Italkebby/Mazda-3-tape-md-aux/btmodule.jpg

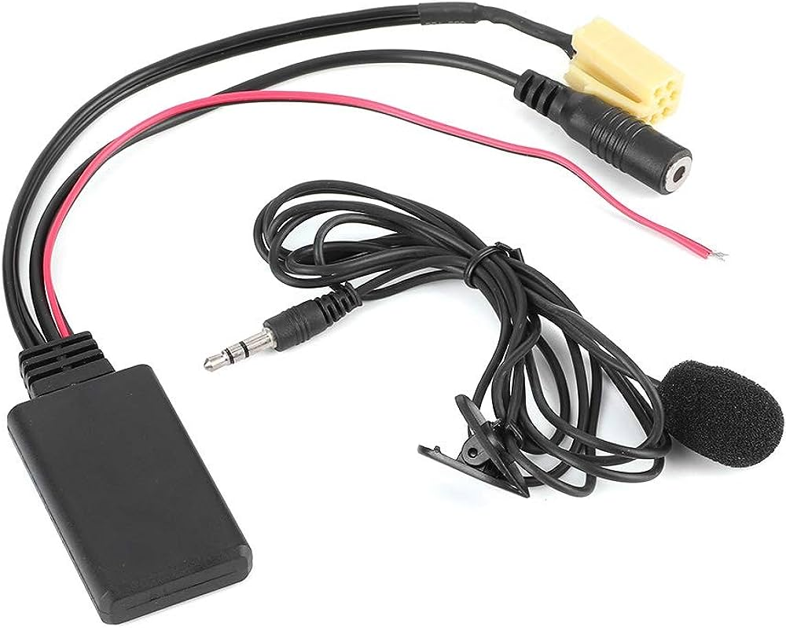
btmodule.jpg
