Italkebby/Mazda-3-tape-md-aux/groundloopinsulator.jpg

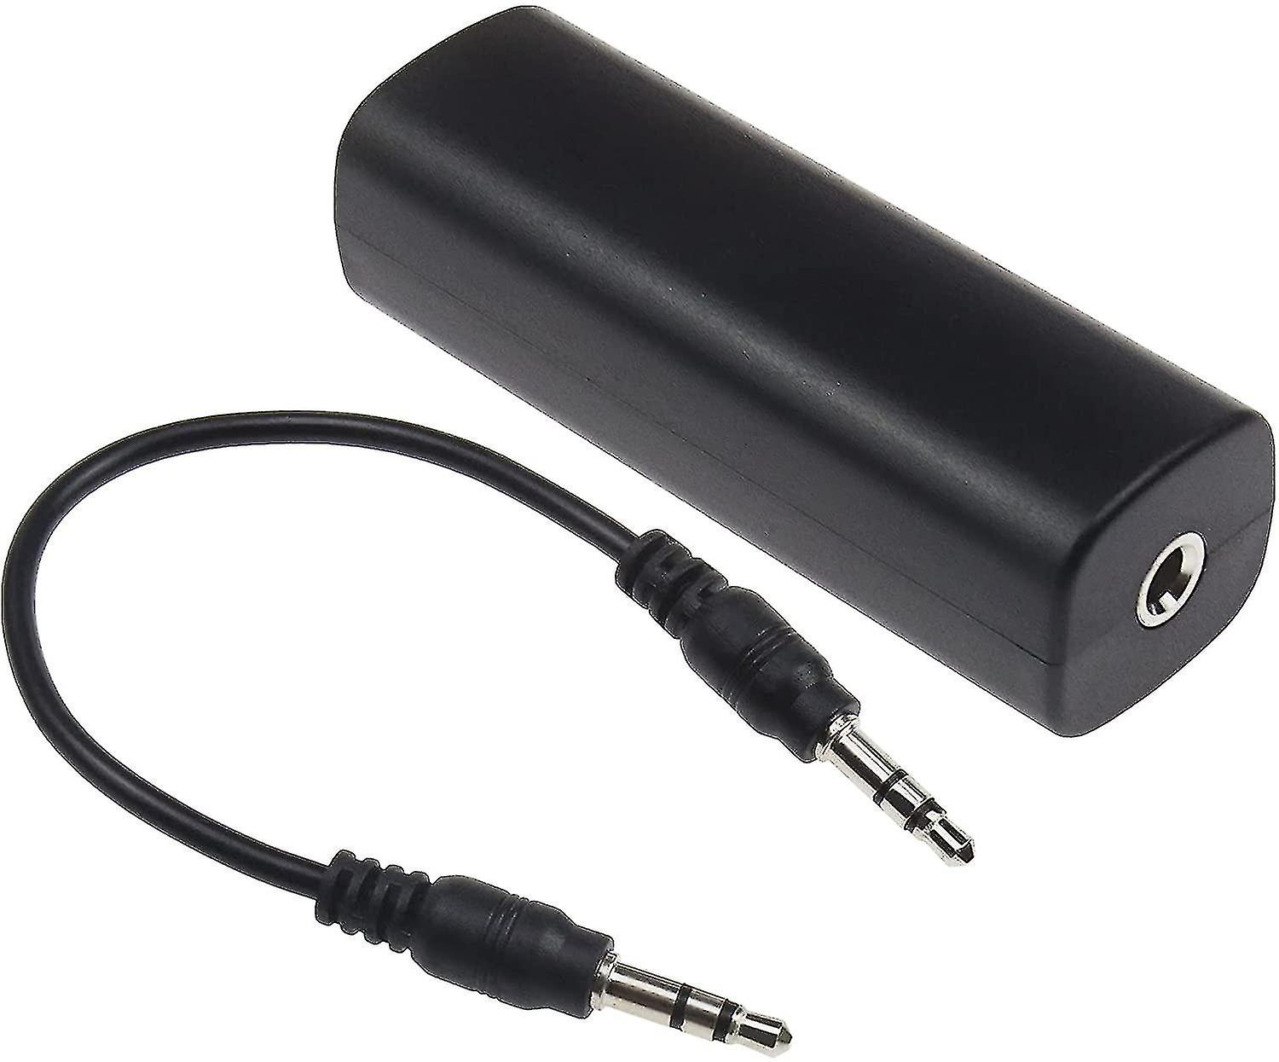
groundloopinsulator.jpg
