Italkebby/Mazda-3-tape-md-aux/mazda_3_int_large.jpg

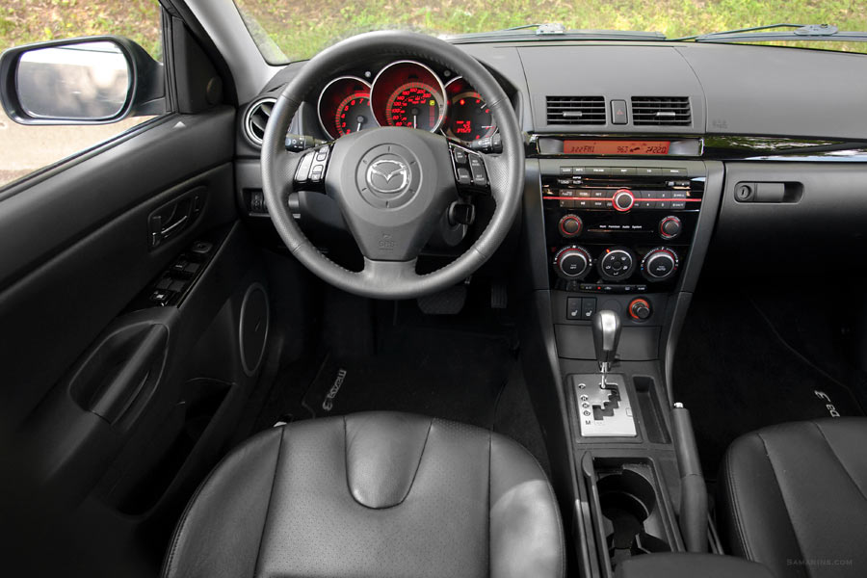
mazda_3_int_large.jpg
