Italkebby/Mazda-3-tape-md-aux/Photos/All in the free space (2).jpg

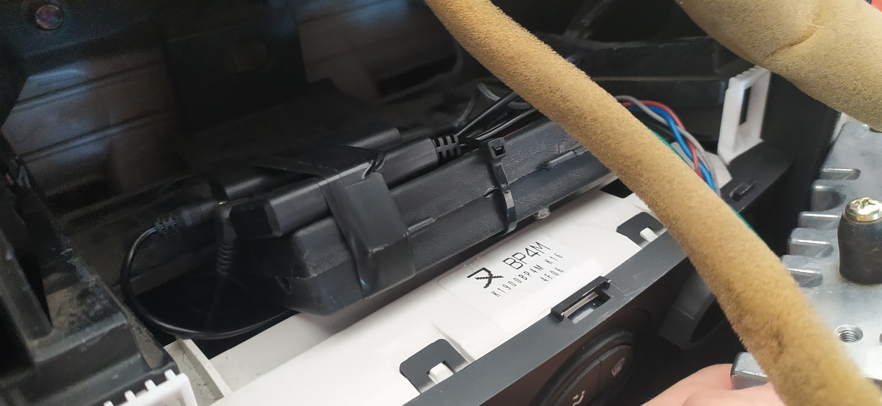
Photos/All in the free space (2).jpg
