Italkebby/Mazda-3-tape-md-aux/Photos/all the system.jpg

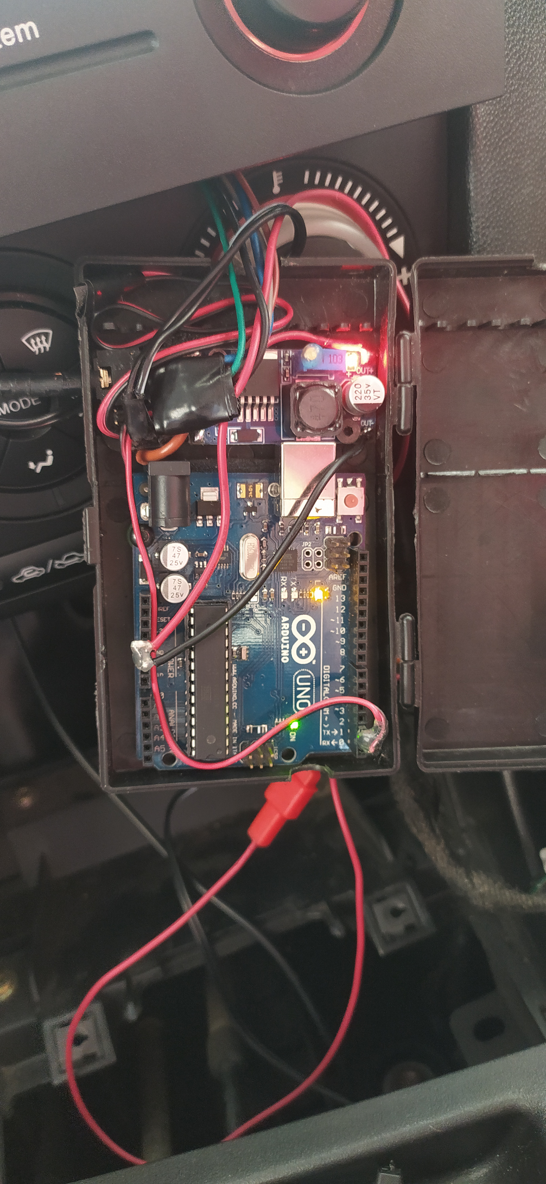
Photos/all the system.jpg
