Italkebby/Mazda-3-tape-md-aux/Photos/arduino and some wires.jpg

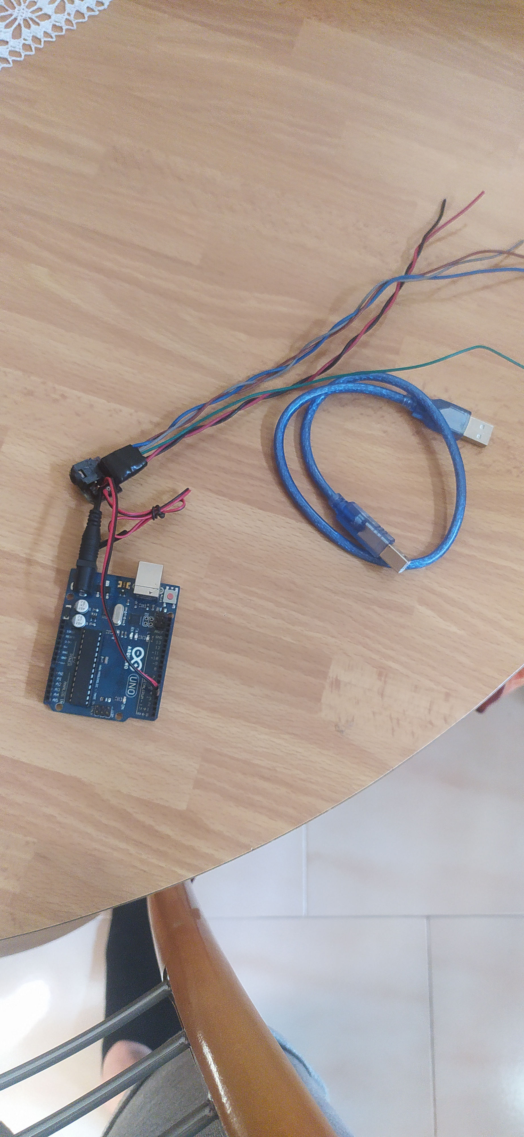
Photos/arduino and some wires.jpg
