Italkebby/Mazda-3-tape-md-aux/Photos/button position (1).jpg

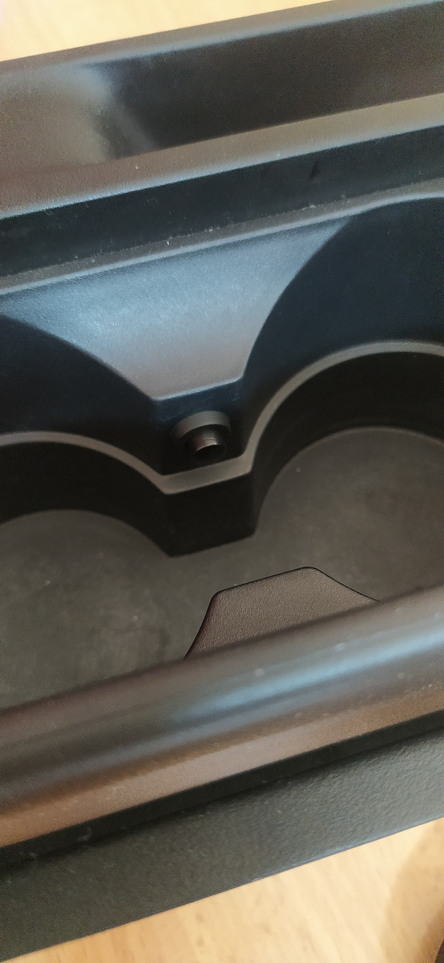
Photos/button position (1).jpg
