Italkebby/Mazda-3-tape-md-aux/Photos/button position with fuse.jpg

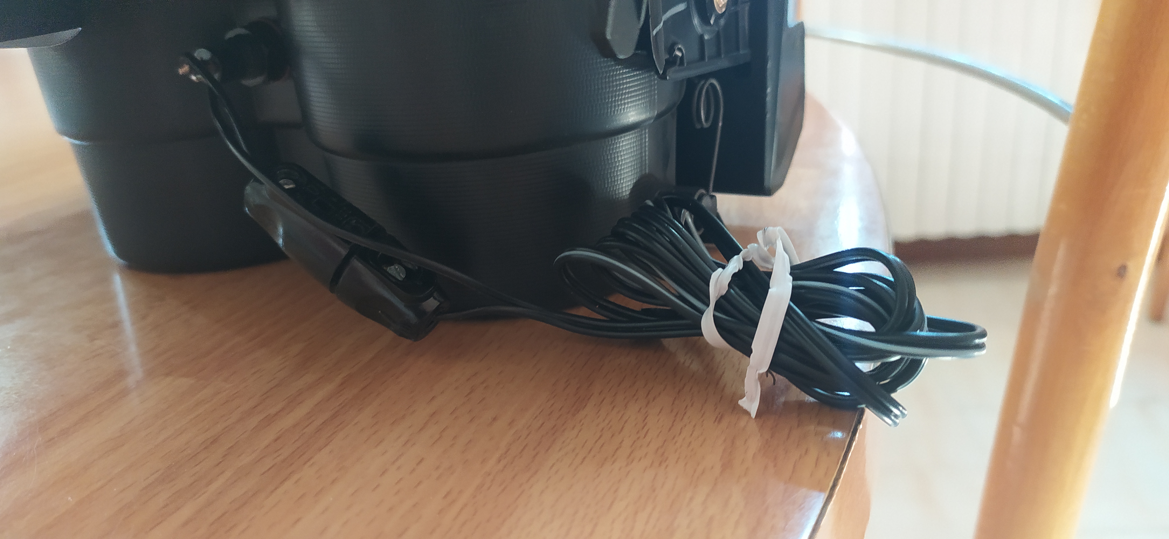
Photos/button position with fuse.jpg
