Italkebby/Mazda-3-tape-md-aux/Photos/faston connector for 12v .jpg

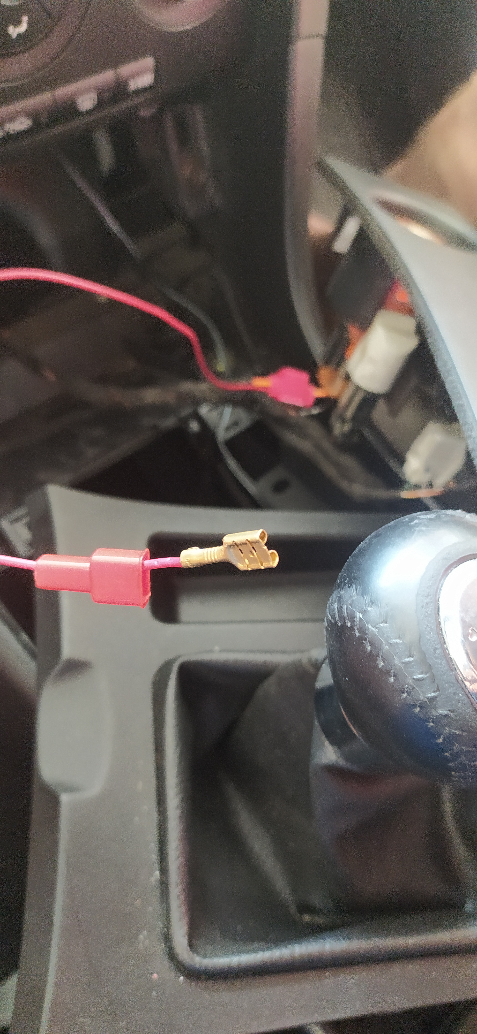
Photos/faston connector for 12v .jpg
