Italkebby/Mazda-3-tape-md-aux/Photos/Free space under Head Unit.jpg

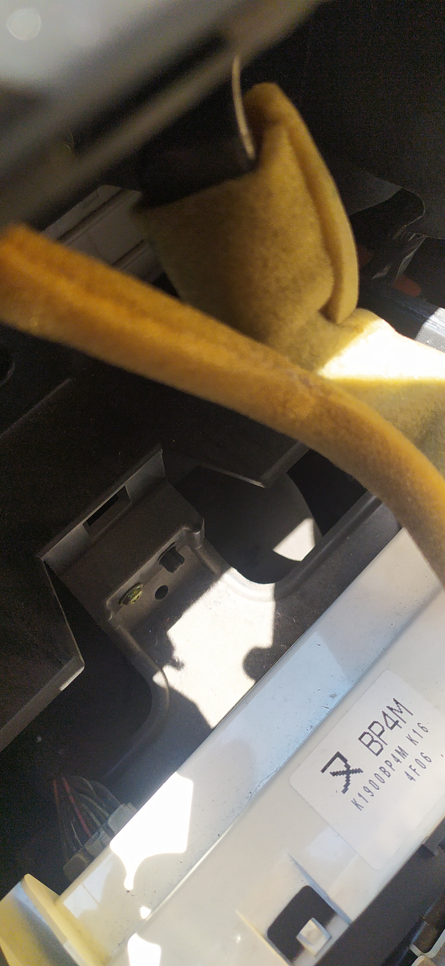
Photos/Free space under Head Unit.jpg
