Italkebby/Mazda-3-tape-md-aux/Photos/System + BT1 .jpg

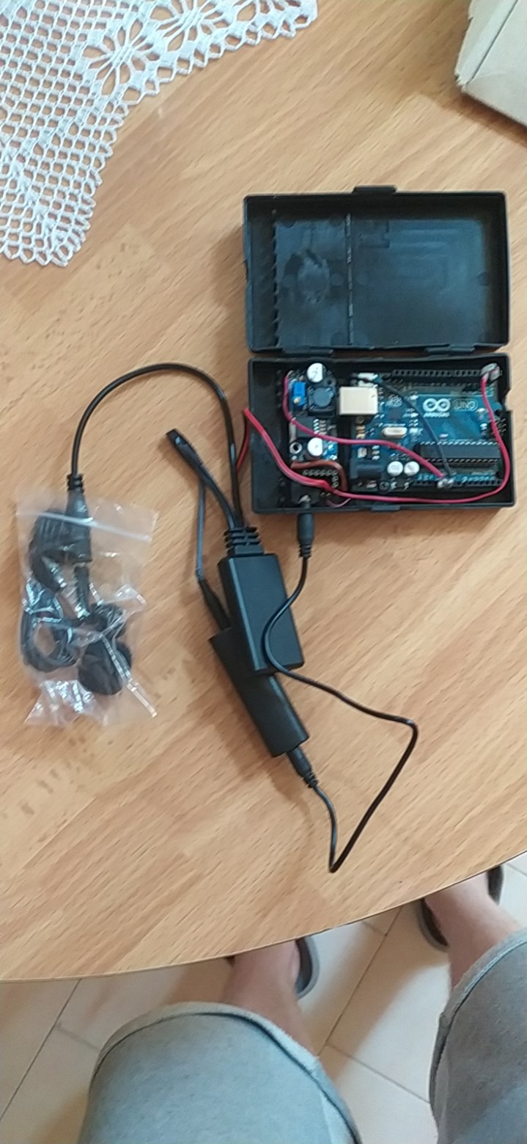
Photos/System + BT1 .jpg
