Italkebby/Mazda-3-tape-md-aux/some of my stuff, ignore them/images.jpg

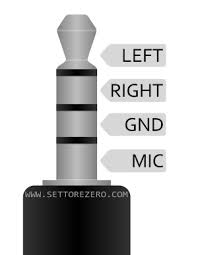
some of my stuff, ignore them/images.jpg
