Italkebby/Mazda-3-tape-md-aux/some of my stuff, ignore them/IMG_20230716_141439.jpg

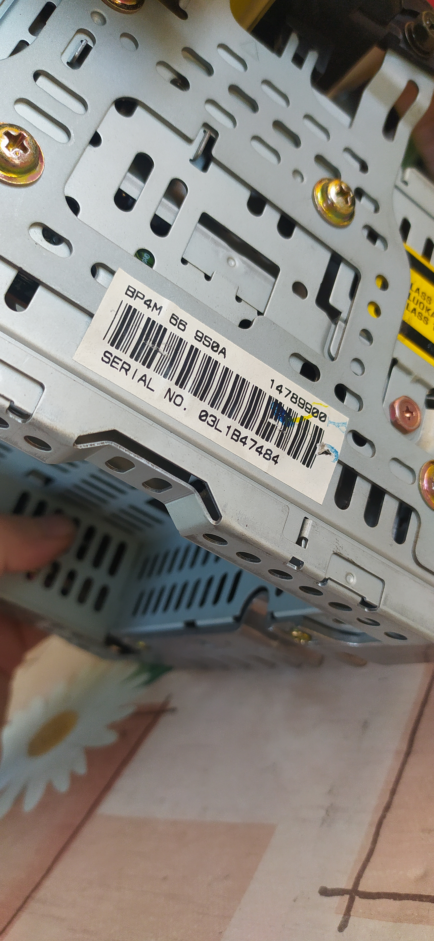
some of my stuff, ignore them/IMG_20230716_141439.jpg
