Italkebby/Mazda-3-tape-md-aux/some of my stuff, ignore them/RCA.webp

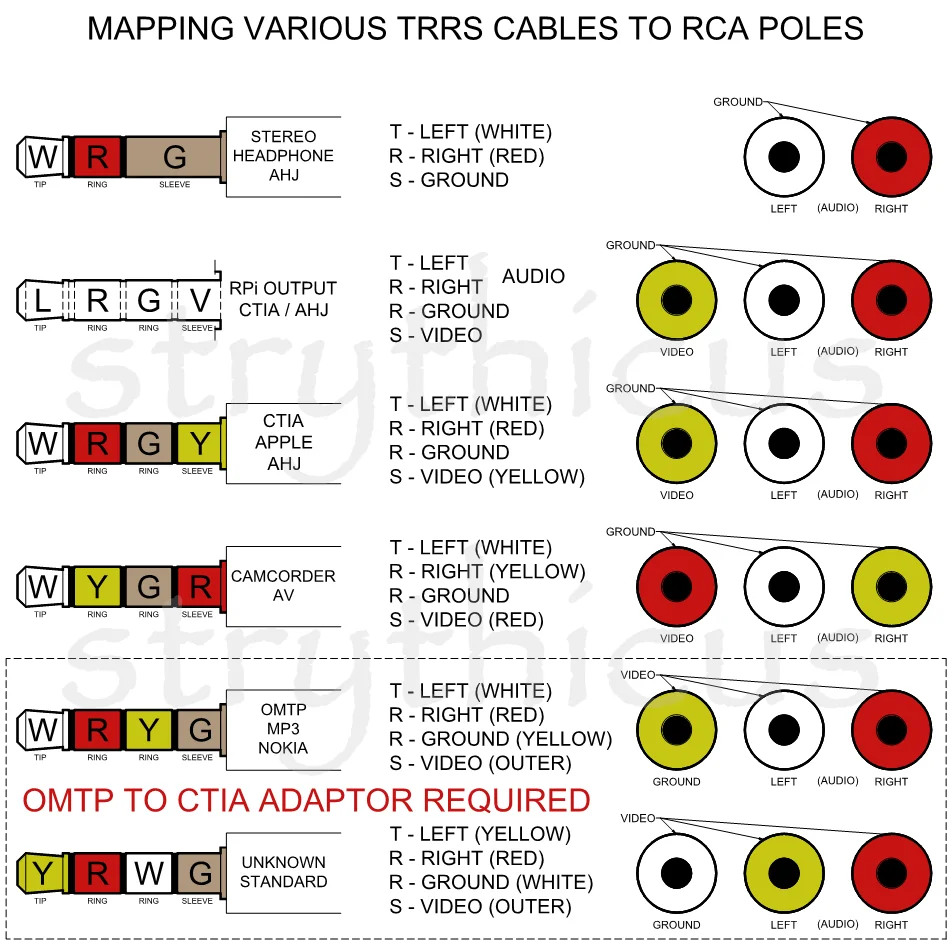
some of my stuff, ignore them/RCA.webp
