Italkebby/Mazda-3-tape-md-aux/(commit log)

2023-09-11 Problema 30sec timout audio
    [Aux_1_1.ino]
2024-04-19 photo that show button to fix the problem
